MartinavdM/TP_AAA/README.md

# TP_AAA

# Scéance 1: Commande des transistors
