MartinavdM/TP_AAA/Inverter_Kicad_Project/Arm_IRF540NBbF.kicad_sch

## KiCad design Inverter_Kicad_Project/Arm_IRF540NBbF.kicad_sch (2023-10-02, last stored version)

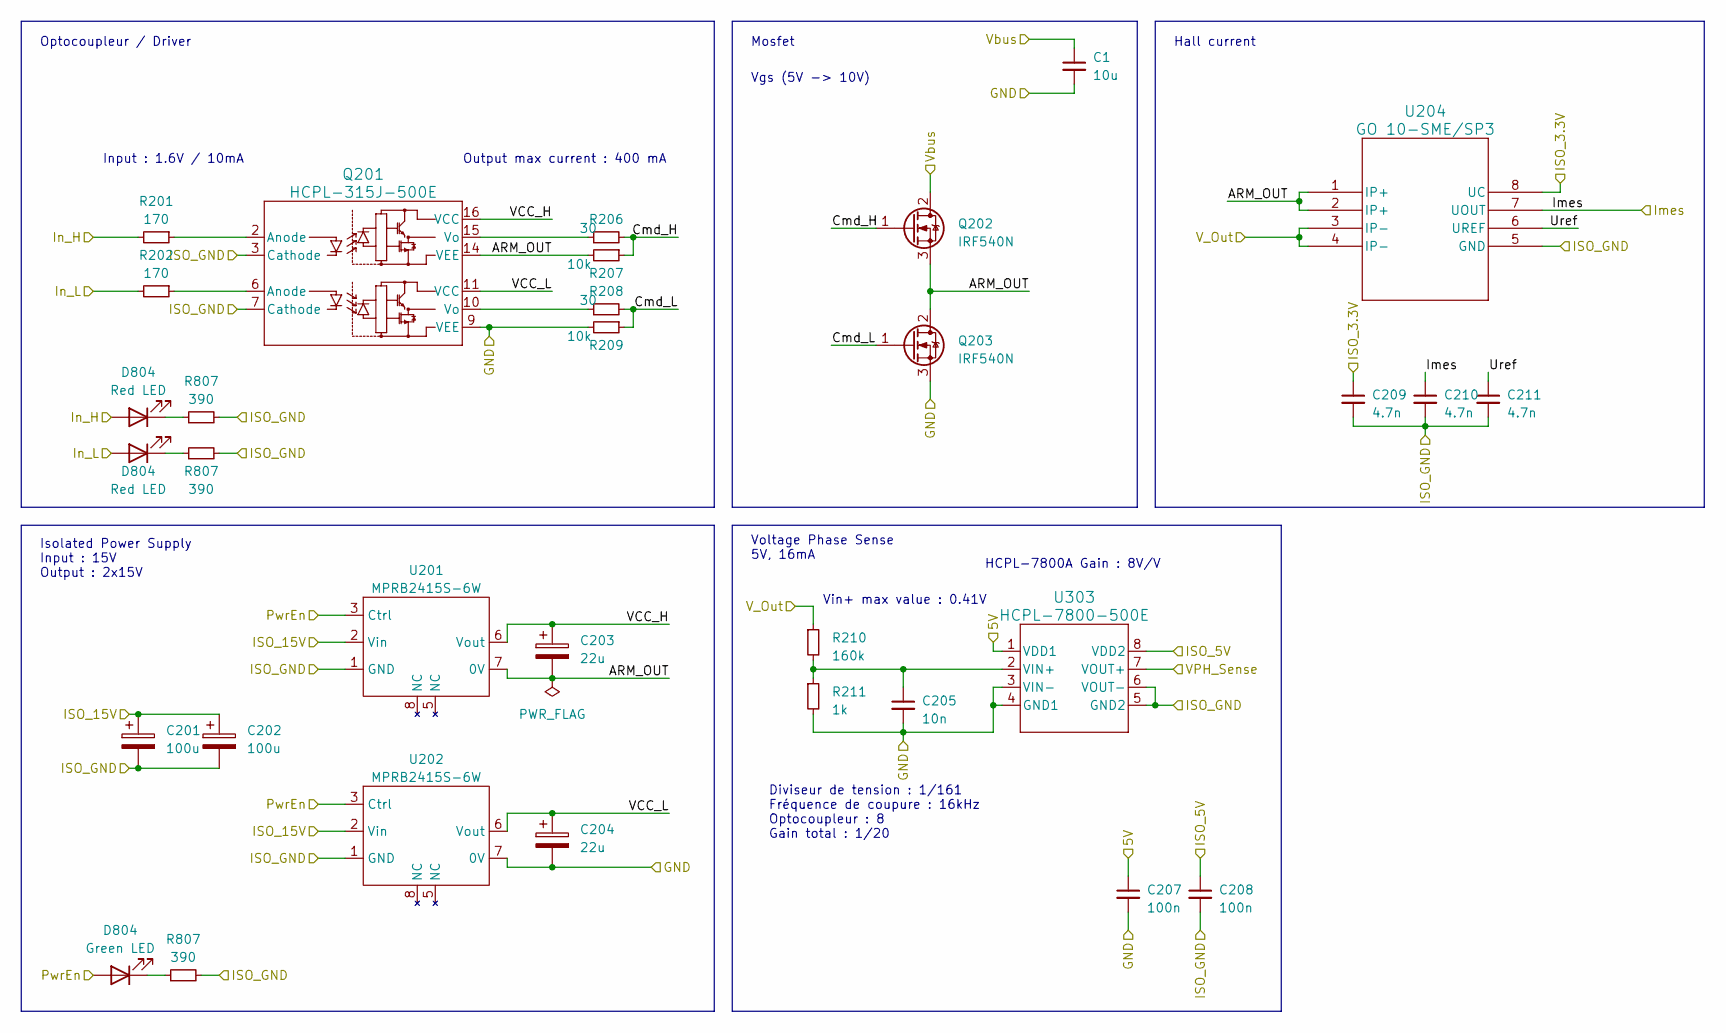
[picture p1: schematic Arm_IRF540NBbF.kicad_sch]

Parts:
C1: 10u; C_2220_5650Metric
C201, C202: 100u; CP_Elec_6.3x7.7
C203, C204: 22u; CP_Elec_5x5.4
C205: 10n; C_0402_1005Metric
C207, C208: 100n; C_0402_1005Metric
C209, C210, C211: 4.7n; C_0402_1005Metric
D804: Red LED; LED_0603_1608Metric
Q201: HCPL-315J-500E; SO-16_HCPL-315J_BRA
Q202, Q203: IRF540N; TO-220-3_Vertical
R201, R202: 170; R_0402_1005Metric
R206, R208: 30; R_1206_3216Metric
R207, R209: 10k; R_0402_1005Metric
R210: 160k; R_0402_1005Metric
R211: 1k; R_0402_1005Metric
R807: 390; R_0402_1005Metric
U201, U202: MPRB2415S-6W; MPRB2415S
U204: GO 10-SME/SP3; SOIC8-GO-SME&slash_SP3_LEM
U303: HCPL-7800-500E; DIP-8 Gull Wing

Connections:
5V: C207.1, U303.1 (VDD1)
ARM_OUT: C203.2, Q201.14 (VEE), Q202.3 (S), Q203.2 (D), R207.2, U201.7 (0V), U204.1 (IP+), U204.2 (IP+)
Cmd_H: Q202.1 (G), R206.2, R207.1
Cmd_L: Q203.1 (G), R208.2, R209.1
GND: C1.2, C204.2, C205.2, C207.2, Q201.9 (VEE), Q203.3 (S), R209.2, R211.2, U202.7 (0V), U303.3 (VIN-), U303.4 (GND1)
ISO_3.3V: C209.1, U204.8 (UC)
ISO_5V: C208.1, U303.8 (VDD2)
ISO_15V: C201.1, C202.1, U201.2 (Vin), U202.2 (Vin)
ISO_GND: C201.2, C202.2, C208.2, C209.2, C210.2, C211.2, Q201.3 (Cathode), Q201.7 (Cathode), R807.2, U201.1 (GND), U202.1 (GND), U204.5 (GND), U303.5 (GND2), U303.6 (VOUT-)
Imes: C210.1, U204.7 (UOUT)
In_H: D804.2 (A), R201.2
In_L: D804.2 (A), R202.2
unnamed: C205.1, R210.2, R211.1, U303.2 (VIN+)
unnamed: D804.1 (K), R807.1
unnamed: Q201.2 (Anode), R201.1
unnamed: Q201.6 (Anode), R202.1
unnamed: Q201.10 (Vo), R208.1
unnamed: Q201.15 (Vo), R206.1
PwrEn: D804.2 (A), U201.3 (Ctrl), U202.3 (Ctrl)
Uref: C211.1, U204.6 (UREF)
VCC_H: C203.1, Q201.16 (VCC), U201.6 (Vout)
VCC_L: C204.1, Q201.11 (VCC), U202.6 (Vout)
VPH_Sense: U303.7 (VOUT+)
V_Out: R210.1, U204.3 (IP-), U204.4 (IP-)
Vbus: C1.1, Q202.2 (D)

Notes on the sheet:
Hall current
Isolated Power Supply Input : 15V Output : 2x15V
Output max current : 400 mA
Input : 1.6V / 10mA
Voltage Phase Sense 5V, 16mA
Vgs (5V -> 10V)
Vin+ max value : 0.41V
Mosfet
Optocoupleur / Driver
Diviseur de tension : 1/161 Fréquence de coupure : 16kHz Optocoupleur : 8 Gain total : 1/20
HCPL-7800A Gain : 8V/V
