MartinavdM/TP_AAA/Inverter_Kicad_Project/FAN.kicad_sch

## KiCad design Inverter_Kicad_Project/FAN.kicad_sch (2023-10-02, last stored version)

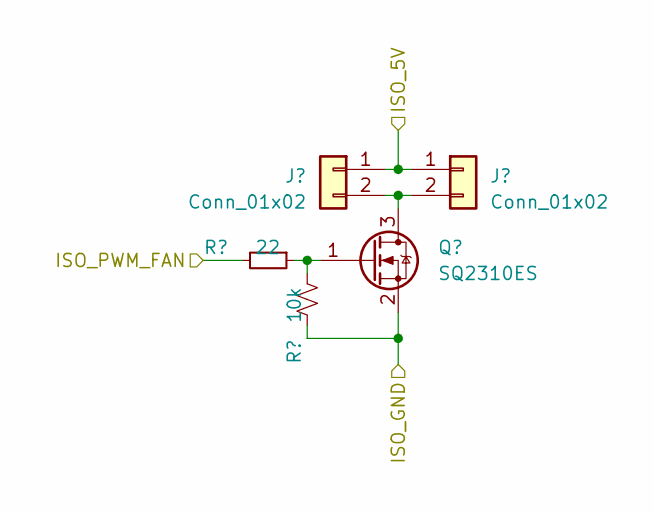
[picture p2: schematic FAN.kicad_sch]

Parts:
J1101, J1102: Conn_01x02; JST_XH_B2B-XH-A_1x02_P2.50mm_Vertical
Q1101: SQ2310ES; SOT-23
R1101: 22; R_0402_1005Metric
R1102: 10k; R_0402_1005Metric

Connections:
ISO_5V: J1101.1, J1102.1
ISO_GND: Q1101.2 (S), R1102.2
ISO_PWM_FAN: R1101.2
unnamed: J1101.2, J1102.2, Q1101.3 (D)
unnamed: Q1101.1 (G), R1101.1, R1102.1
