MartinavdM/TP_AAA/Inverter_Kicad_Project/Inverter_KiCAD.kicad_sch

## KiCad design Inverter_Kicad_Project/Inverter_KiCAD.kicad_sch (2023-10-02, last stored version)

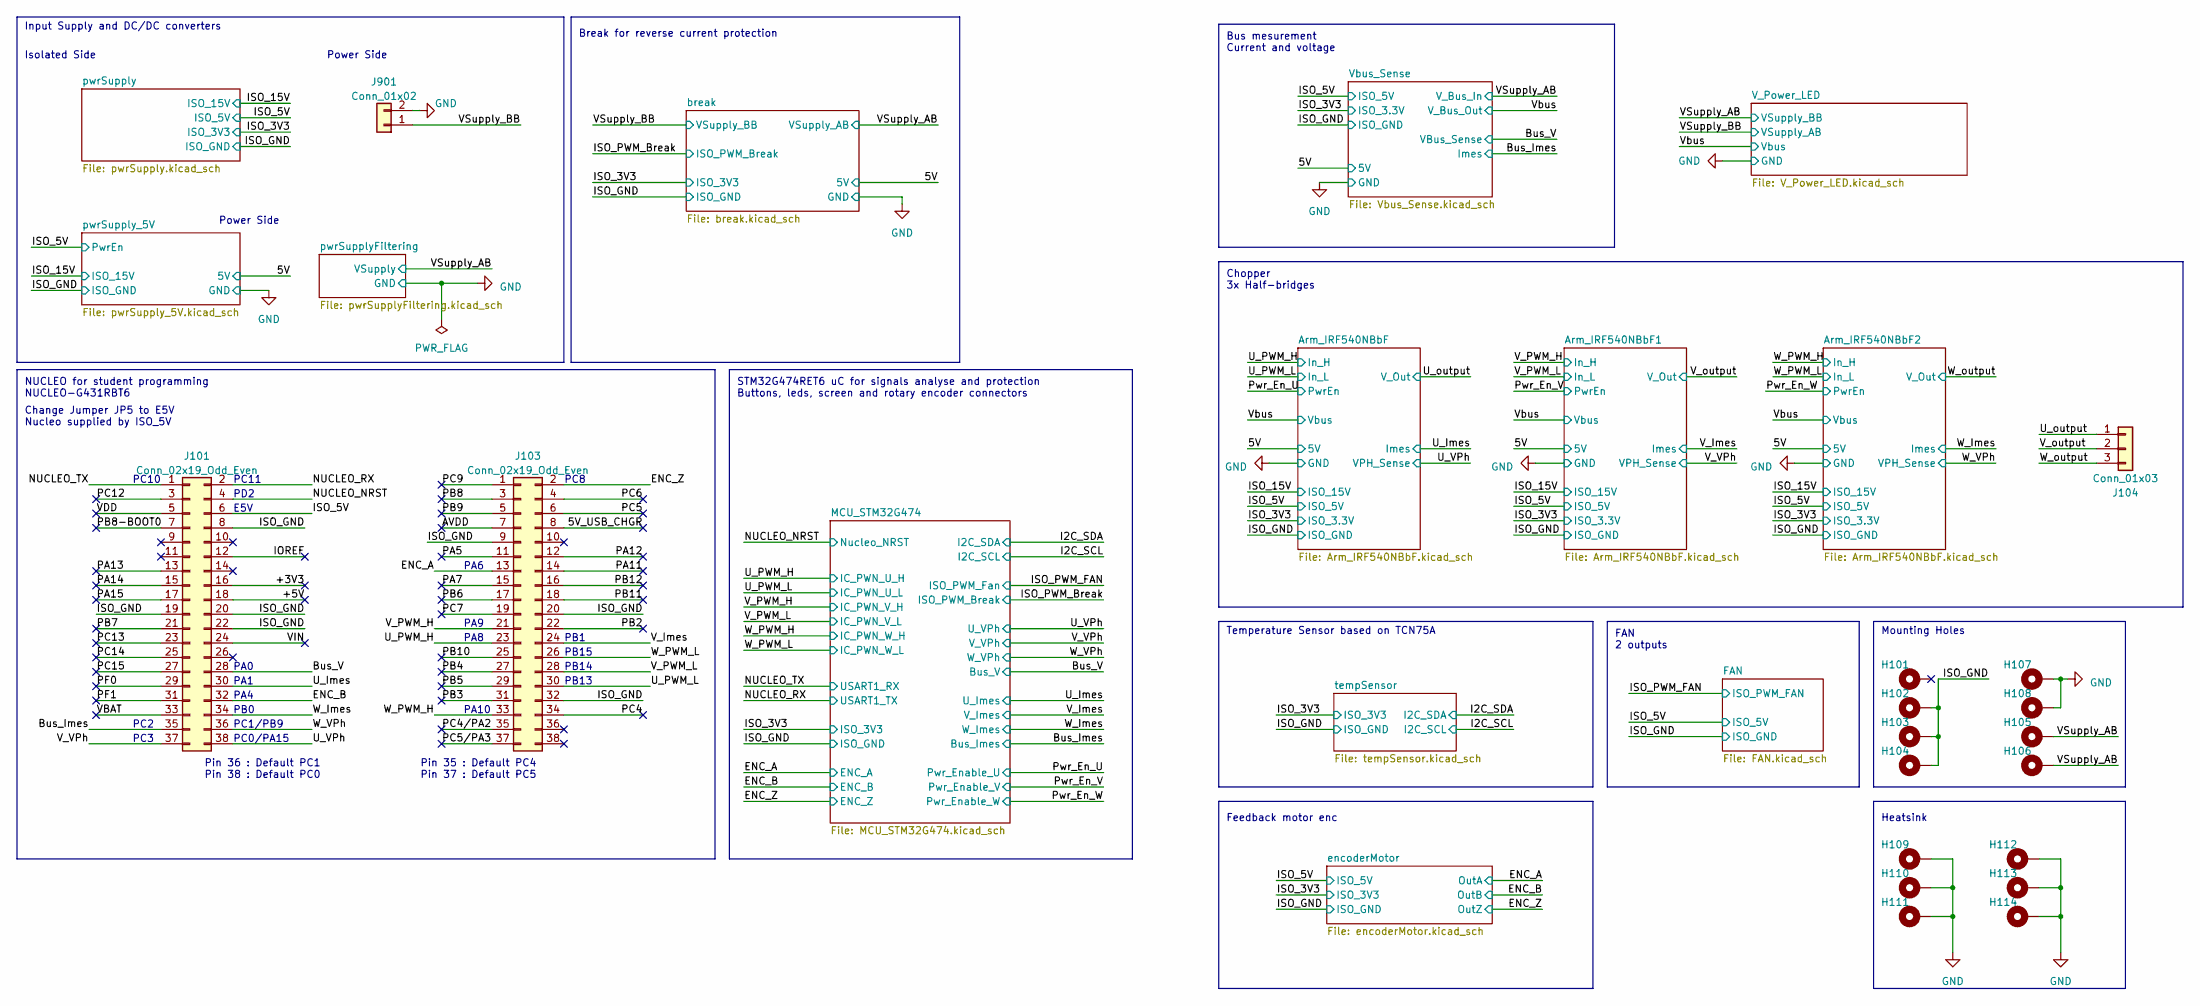
[picture p3: schematic Inverter_KiCAD.kicad_sch]

Parts:
H101, H102, H103, H104, H105, H106, H107, H108, H109, H110, H111, H112, H113, H114: MountingHole_Pad; MountingHole_3.2mm_M3_Pad_Via
J101, J103: Conn_02x19_Odd_Even; PinHeader_2x19_P2.54mm_Vertical
J104: Conn_01x03; 691311500103
J901: Conn_01x02; 691311500102

Connections:
5V_USB_CHGR: J103.8
+3V3: J101.16
+5V: J101.18
AVDD: J103.7
Bus_Imes: J101.35
Bus_V: J101.28
ENC_A: J103.13
ENC_B: J101.32
ENC_Z: J103.2
GND: H107.1, H108.1, H109.1, H110.1, H111.1, H112.1, H113.1, H114.1, J901.2
IOREF: J101.12
ISO_5V: J101.6
ISO_GND: H102.1, H103.1, H104.1, J101.8, J101.19, J101.20, J101.22, J103.9, J103.20, J103.32
NUCLEO_NRST: J101.4
NUCLEO_RX: J101.2
NUCLEO_TX: J101.1
PA5: J103.11
PA7: J103.15
PA11: J103.14
PA12: J103.12
PA13: J101.13
PA14: J101.15
PA15: J101.17
PB2: J103.22
PB3: J103.31
PB4: J103.27
PB5: J103.29
PB6: J103.17
PB7: J101.21
PB8: J103.3
PB8-BOOT0: J101.7
PB9: J103.5
PB10: J103.25
PB11: J103.18
PB12: J103.16
PC4: J103.34
PC4/PA2: J103.35
PC5: J103.6
PC5/PA3: J103.37
PC6: J103.4
PC7: J103.19
PC9: J103.1
PC12: J101.3
PC13: J101.23
PC14: J101.25
PC15: J101.27
PF0: J101.29
PF1: J101.31
U_Imes: J101.30
U_PWM_H: J103.23
U_PWM_L: J103.30
U_VPh: J101.38
U_output: J104.1
VBAT: J101.33
VDD: J101.5
VIN: J101.24
VSupply_AB: H105.1, H106.1
VSupply_BB: J901.1
V_Imes: J103.24
V_PWM_H: J103.21
V_PWM_L: J103.28
V_VPh: J101.37
V_output: J104.2
W_Imes: J101.34
W_PWM_H: J103.33
W_PWM_L: J103.26
W_VPh: J101.36
W_output: J104.3

Notes on the sheet:
PB14
PC10
Input Supply and DC/DC converters
Temperature Sensor based on TCN75A
PC3
PA8
Mounting Holes
PA4
NUCLEO for student programming NUCLEO-G431RBT6
Pin 35 : Default PC4 Pin 37 : Default PC5
PA10
STM32G474RET6 uC for signals analyse and protection Buttons, leds, screen and rotary encoder connectors
Heatsink
Break for reverse current protection
PB13
Chopper 3x Half-bridges
PA0
PC0/PA15
PD2
E5V
PB0
PA9
Power Side
Feedback motor enc
Isolated Side
PA6
PC11
FAN 2 outputs
PA1
Pin 36 : Default PC1 Pin 38 : Default PC0
PC1/PB9
PC8
PB1
PC2
Bus mesurement Current and voltage
PB15
Change Jumper JP5 to E5V Nucleo supplied by ISO_5V
