MartinavdM/TP_AAA/Inverter_Kicad_Project/MCU_STM32G474.kicad_sch

## KiCad design Inverter_Kicad_Project/MCU_STM32G474.kicad_sch (2023-10-02, last stored version)

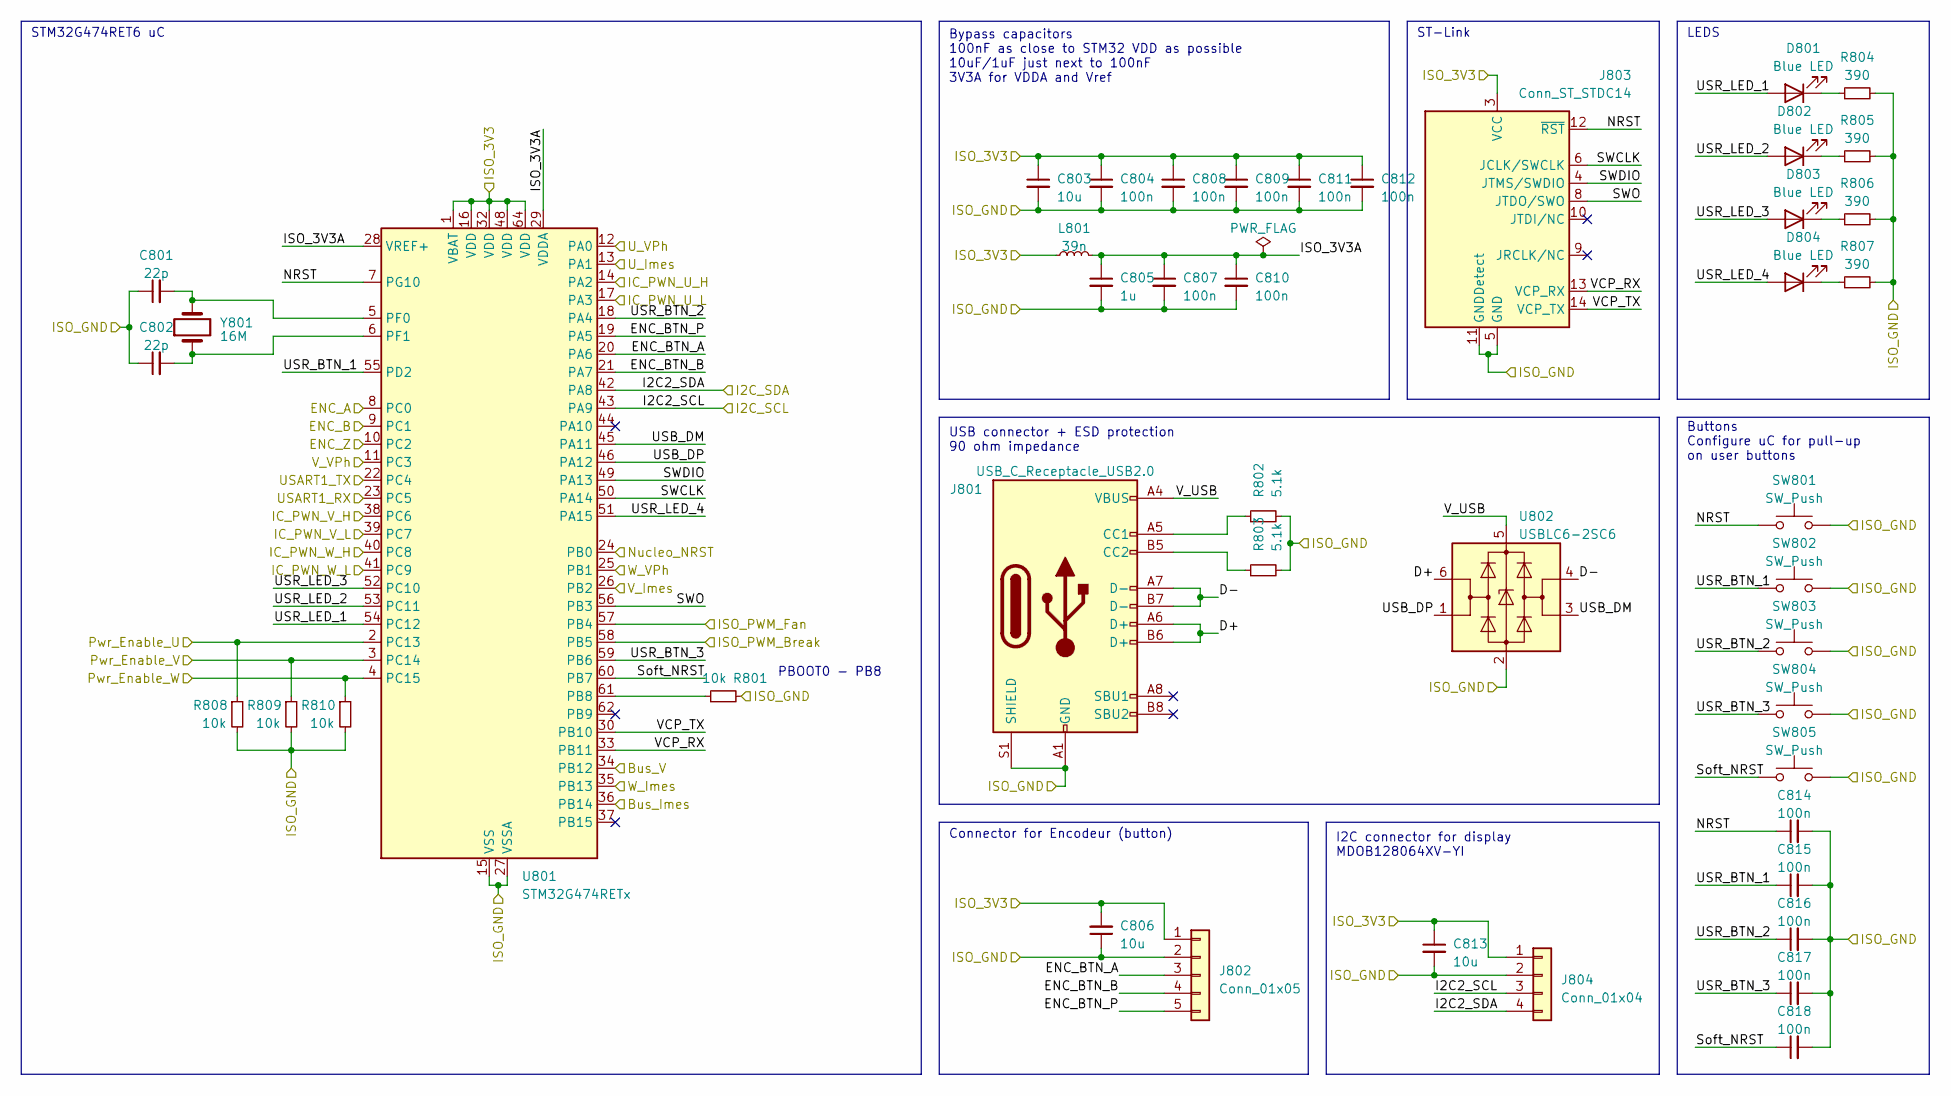
[picture p4: schematic MCU_STM32G474.kicad_sch]

Parts:
C801, C802: 22p; C_0402_1005Metric
C803, C806, C813: 10u; C_0603_1608Metric
C804, C807, C808, C809, C810, C811, C812, C814, C815, C816, C817, C818: 100n; C_0402_1005Metric
C805: 1u; C_0402_1005Metric
D801, D802, D803, D804: Blue LED; LED_0603_1608Metric
J801: USB_C_Receptacle_USB2.0; USB_C_Receptacle_HRO_TYPE-C-31-M-12
J802: Conn_01x05; JST_XH_B5B-XH-A_1x05_P2.50mm_Vertical
J803: Conn_ST_STDC14; PinHeader_2x07_P1.27mm_Vertical_SMD
J804: Conn_01x04; JST_XH_B4B-XH-A_1x04_P2.50mm_Vertical
L801: 39n; L_0603_1608Metric
R801, R808, R809, R810: 10k; R_0402_1005Metric
R802, R803: 5.1k; R_0402_1005Metric
R804, R805, R806, R807: 390; R_0402_1005Metric
SW801, SW802, SW803, SW804, SW805: SW_Push; 435451019820
U801: STM32G474RETx; LQFP-64_10x10mm_P0.5mm
U802: USBLC6-2SC6; SOT-23-6
Y801: 16M; ABLS-7.3728MHZ-CL-RESR-A-1-G-F

Connections:
Bus_Imes: U801.36 (PB14)
Bus_V: U801.34 (PB12)
D+: J801.A6 (D+), J801.B6 (D+), U802.6 (I/O1)
D-: J801.A7 (D-), J801.B7 (D-), U802.4 (I/O2)
ENC_A: U801.8 (PC0)
ENC_B: U801.9 (PC1)
ENC_BTN_A: J802.3, U801.20 (PA6)
ENC_BTN_B: J802.4, U801.21 (PA7)
ENC_BTN_P: J802.5, U801.19 (PA5)
ENC_Z: U801.10 (PC2)
I2C2_SCL: J804.3, U801.43 (PA9)
I2C2_SDA: J804.4, U801.42 (PA8)
IC_PWN_U_H: U801.14 (PA2)
IC_PWN_U_L: U801.17 (PA3)
IC_PWN_V_H: U801.38 (PC6)
IC_PWN_V_L: U801.39 (PC7)
IC_PWN_W_H: U801.40 (PC8)
IC_PWN_W_L: U801.41 (PC9)
ISO_3V3: C803.1, C804.1, C806.2, C808.1, C809.1, C811.1, C812.1, C813.1, J802.1, J803.3 (VCC), J804.1, L801.1, U801.1 (VBAT), U801.16 (VDD), U801.32 (VDD), U801.48 (VDD), U801.64 (VDD)
ISO_3V3A: C805.1, C807.1, C810.1, L801.2, U801.28 (VREF+), U801.29 (VDDA)
ISO_GND: C801.1, C802.1, C803.2, C804.2, C805.2, C806.1, C807.2, C808.2, C809.2, C810.2, C811.2, C812.2, C813.2, C814.2, C815.2, C816.2, C817.2, C818.2, J801.A1 (GND), J801.A12 (GND), J801.B1 (GND), J801.B12 (GND), J801.S1 (SHIELD), J802.2, J803.5 (GND), J803.7 (GND), J803.11 (GNDDetect), J804.2, R801.2, R802.2, R803.2, R804.2, R805.2, R806.2, R807.2, R808.2, R809.2, R810.2, SW801.2, SW802.2, SW803.2, SW804.2, SW805.2, U801.15 (VSS), U801.27 (VSSA), U801.31 (VSS), U801.47 (VSS), U801.63 (VSS), U802.2 (GND)
ISO_PWM_Break: U801.58 (PB5)
ISO_PWM_Fan: U801.57 (PB4)
NRST: C814.1, J803.12 (~RST), SW801.1, U801.7 (PG10)
unnamed: C801.2, U801.5 (PF0), Y801.2
unnamed: C802.2, U801.6 (PF1), Y801.1
unnamed: D801.1 (K), R804.1
unnamed: D802.1 (K), R805.1
unnamed: D803.1 (K), R806.1
unnamed: D804.1 (K), R807.1
unnamed: J801.A5 (CC1), R802.1
unnamed: J801.B5 (CC2), R803.1
unnamed: R801.1, U801.61 (PB8)
Nucleo_NRST: U801.24 (PB0)
Pwr_Enable_U: R808.1, U801.2 (PC13)
Pwr_Enable_V: R809.1, U801.3 (PC14)
Pwr_Enable_W: R810.1, U801.4 (PC15)
SWCLK: J803.6 (JCLK/SWCLK), U801.50 (PA14)
SWDIO: J803.4 (JTMS/SWDIO), U801.49 (PA13)
SWO: J803.8 (JTDO/SWO), U801.56 (PB3)
Soft_NRST: C818.1, SW805.1, U801.60 (PB7)
USART1_RX: U801.23 (PC5)
USART1_TX: U801.22 (PC4)
USB_DM: U801.45 (PA11), U802.3 (I/O2)
USB_DP: U801.46 (PA12), U802.1 (I/O1)
USR_BTN_1: C815.1, SW802.1, U801.55 (PD2)
USR_BTN_2: C816.1, SW803.1, U801.18 (PA4)
USR_BTN_3: C817.1, SW804.1, U801.59 (PB6)
USR_LED_1: D801.2 (A), U801.54 (PC12)
USR_LED_2: D802.2 (A), U801.53 (PC11)
USR_LED_3: D803.2 (A), U801.52 (PC10)
USR_LED_4: D804.2 (A), U801.51 (PA15)
U_Imes: U801.13 (PA1)
U_VPh: U801.12 (PA0)
VCP_RX: J803.13 (VCP_RX), U801.33 (PB11)
VCP_TX: J803.14 (VCP_TX), U801.30 (PB10)
V_Imes: U801.26 (PB2)
V_USB: J801.A4 (VBUS), J801.A9 (VBUS), J801.B4 (VBUS), J801.B9 (VBUS), U802.5 (VBUS)
V_VPh: U801.11 (PC3)
W_Imes: U801.35 (PB13)
W_VPh: U801.25 (PB1)

Notes on the sheet:
USB connector + ESD protection 90 ohm impedance
ST-Link
Bypass capacitors 100nF as close to STM32 VDD as possible 10uF/1uF just next to 100nF 3V3A for VDDA and Vref
Connector for Encodeur (button)
Buttons Configure uC for pull-up on user buttons
I2C connector for display MDOB128064XV-YI
PBOOT0 - PB8
STM32G474RET6 uC
LEDS
