MartinavdM/TP_AAA/Inverter_Kicad_Project/V_Power_LED.kicad_sch

## KiCad design Inverter_Kicad_Project/V_Power_LED.kicad_sch (2023-10-02, last stored version)

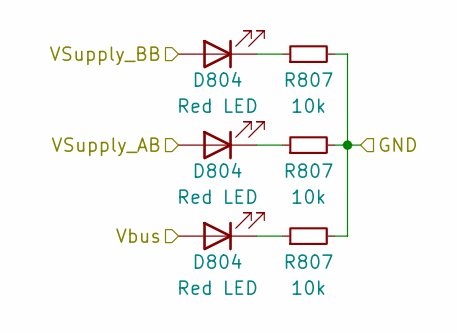
[picture p5: schematic V_Power_LED.kicad_sch]

Parts:
D804: Red LED; LED_0603_1608Metric
R807: 10k; R_0402_1005Metric

Connections:
GND: R807.2
unnamed: D804.1 (K), R807.1
VSupply_AB: D804.2 (A)
VSupply_BB: D804.2 (A)
Vbus: D804.2 (A)
