MartinavdM/TP_AAA/Inverter_Kicad_Project/Vbus_Sense.kicad_sch

## KiCad design Inverter_Kicad_Project/Vbus_Sense.kicad_sch (2023-10-02, last stored version)

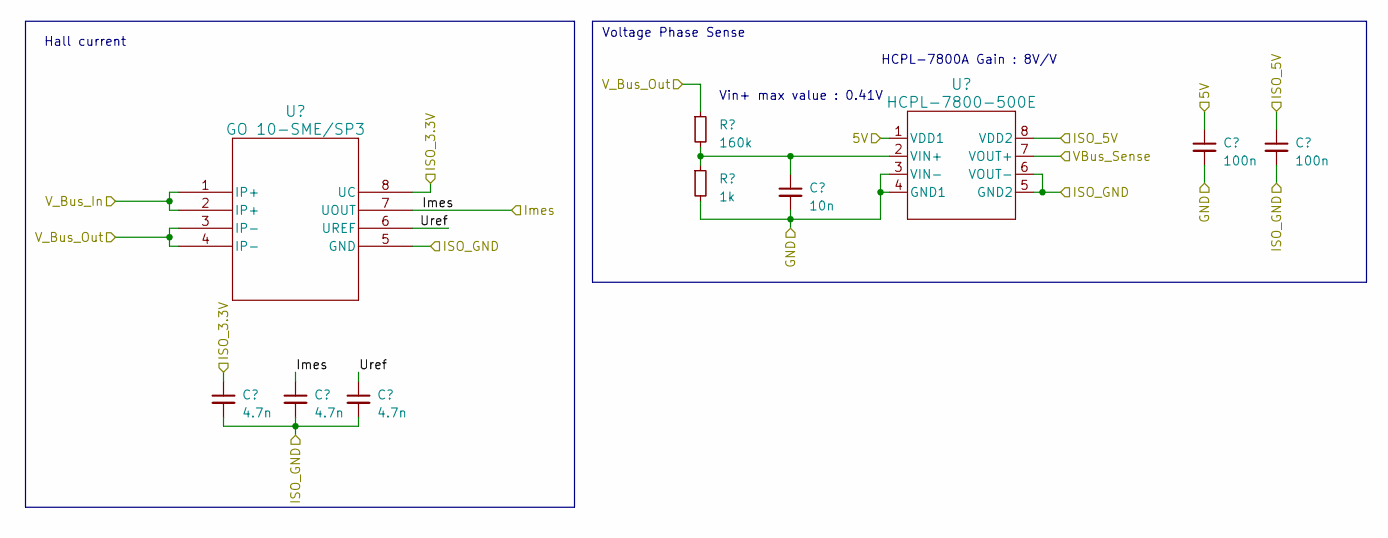
[picture p6: schematic Vbus_Sense.kicad_sch]

Parts:
C601, C602, C603: 4.7n; C_0402_1005Metric
C604: 10n; C_0402_1005Metric
C605, C606: 100n; C_0402_1005Metric
R601: 160k; R_0402_1005Metric
R602: 1k; R_0402_1005Metric
U601: GO 10-SME/SP3; SOIC8-GO-SME&slash_SP3_LEM
U602: HCPL-7800-500E; DIP-8 Gull Wing

Connections:
5V: C605.1, U602.1 (VDD1)
GND: C604.2, C605.2, R602.2, U602.3 (VIN-), U602.4 (GND1)
ISO_3.3V: C601.1, U601.8 (UC)
ISO_5V: C606.1, U602.8 (VDD2)
ISO_GND: C601.2, C602.2, C603.2, C606.2, U601.5 (GND), U602.5 (GND2), U602.6 (VOUT-)
Imes: C602.1, U601.7 (UOUT)
unnamed: C604.1, R601.2, R602.1, U602.2 (VIN+)
Uref: C603.1, U601.6 (UREF)
VBus_Sense: U602.7 (VOUT+)
V_Bus_In: U601.1 (IP+), U601.2 (IP+)
V_Bus_Out: R601.1, U601.3 (IP-), U601.4 (IP-)

Notes on the sheet:
Hall current
Vin+ max value : 0.41V
HCPL-7800A Gain : 8V/V
Voltage Phase Sense
