MartinavdM/TP_AAA/Inverter_Kicad_Project/break.kicad_sch

## KiCad design Inverter_Kicad_Project/break.kicad_sch (2023-10-02, last stored version)

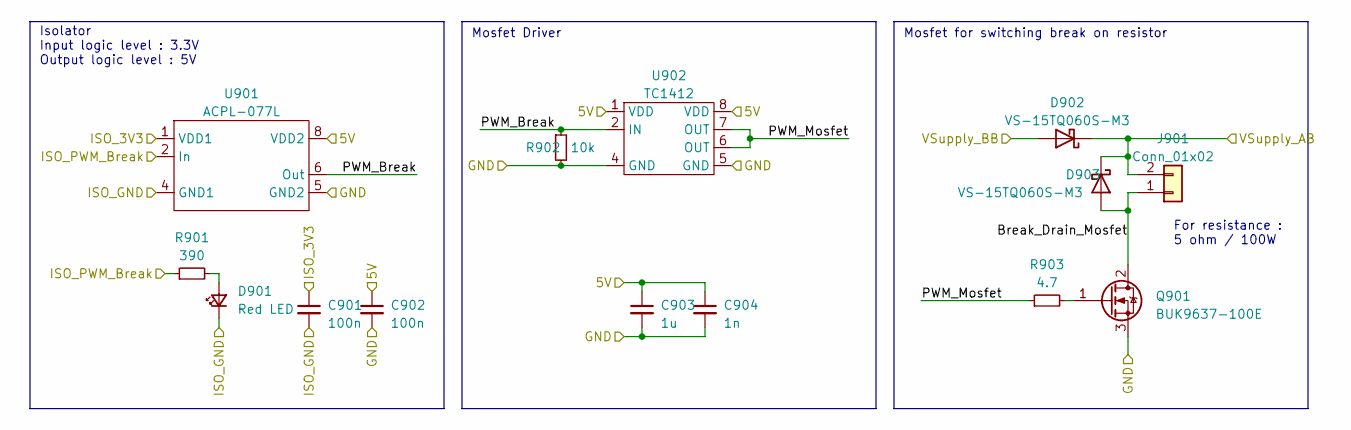
[picture p7: schematic break.kicad_sch]

Parts:
C901, C902: 100n; C_0402_1005Metric
C903: 1u; C_0402_1005Metric
C904: 1n; C_0402_1005Metric
D901: Red LED; LED_0603_1608Metric
D902, D903: VS-15TQ060S-M3; TO-263-2
J901: Conn_01x02; 691311500102
Q901: BUK9637-100E; TO-263-2
R901: 390; R_0402_1005Metric
R902: 10k; R_0402_1005Metric
R903: 4.7; R_1206_3216Metric
U901: ACPL-077L; SO-8_3.9x4.9mm_P1.27mm
U902: TC1412; SOIC-8_3.9x4.9mm_P1.27mm

Connections:
5V: C902.1, C903.1, C904.1, U901.8 (VDD2), U902.1 (VDD), U902.8 (VDD)
Break_Drain_Mosfet: D903.3 (A), J901.1, Q901.2 (D)
GND: C902.2, C903.2, C904.2, Q901.3 (S), R902.2, U901.5 (GND2), U902.4 (GND), U902.5 (GND)
ISO_3V3: C901.1, U901.1 (VDD1)
ISO_GND: C901.2, D901.1 (K), U901.4 (GND1)
ISO_PWM_Break: R901.1, U901.2 (In)
unnamed: D901.2 (A), R901.2
unnamed: Q901.1 (G), R903.2
PWM_Break: R902.1, U901.6 (Out), U902.2 (IN)
PWM_Mosfet: R903.1, U902.6 (OUT), U902.7 (OUT)
VSupply_AB: D902.2 (K), D903.2 (K), J901.2
VSupply_BB: D902.3 (A)

Notes on the sheet:
Isolator Input logic level : 3.3V Output logic level : 5V
For resistance : 5 ohm / 100W
Mosfet for switching break on resistor
Mosfet Driver
