MartinavdM/TP_AAA/Inverter_Kicad_Project/encoderMotor.kicad_sch

## KiCad design Inverter_Kicad_Project/encoderMotor.kicad_sch (2023-10-02, last stored version)

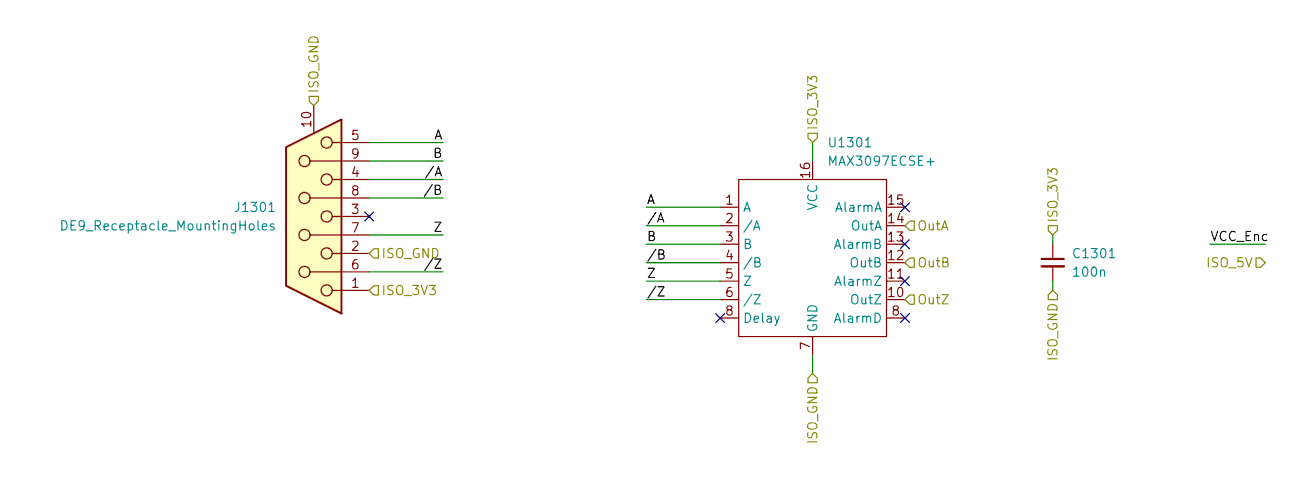
[picture p8: schematic encoderMotor.kicad_sch]

Parts:
C1301: 100n; C_0402_1005Metric
J1301: DE9_Receptacle_MountingHoles; 618009233821
U1301: MAX3097ECSE+; SOIC-16_3.9x9.9mm_P1.27mm

Connections:
A: J1301.5, U1301.1 (A)
B: J1301.9, U1301.3 (B)
ISO_3V3: C1301.1, J1301.1, U1301.16 (VCC)
ISO_GND: C1301.2, J1301.2, J1301.10 (PAD), U1301.7 (GND)
OutA: U1301.14 (OutA)
OutB: U1301.12 (OutB)
OutZ: U1301.10 (OutZ)
Z: J1301.7, U1301.5 (Z)
/A: J1301.4, U1301.2 (/A)
/B: J1301.8, U1301.4 (/B)
/Z: J1301.6, U1301.6 (/Z)
