MartinavdM/TP_AAA/Inverter_Kicad_Project/pwrSupply.kicad_sch

## KiCad design Inverter_Kicad_Project/pwrSupply.kicad_sch (2023-10-02, last stored version)

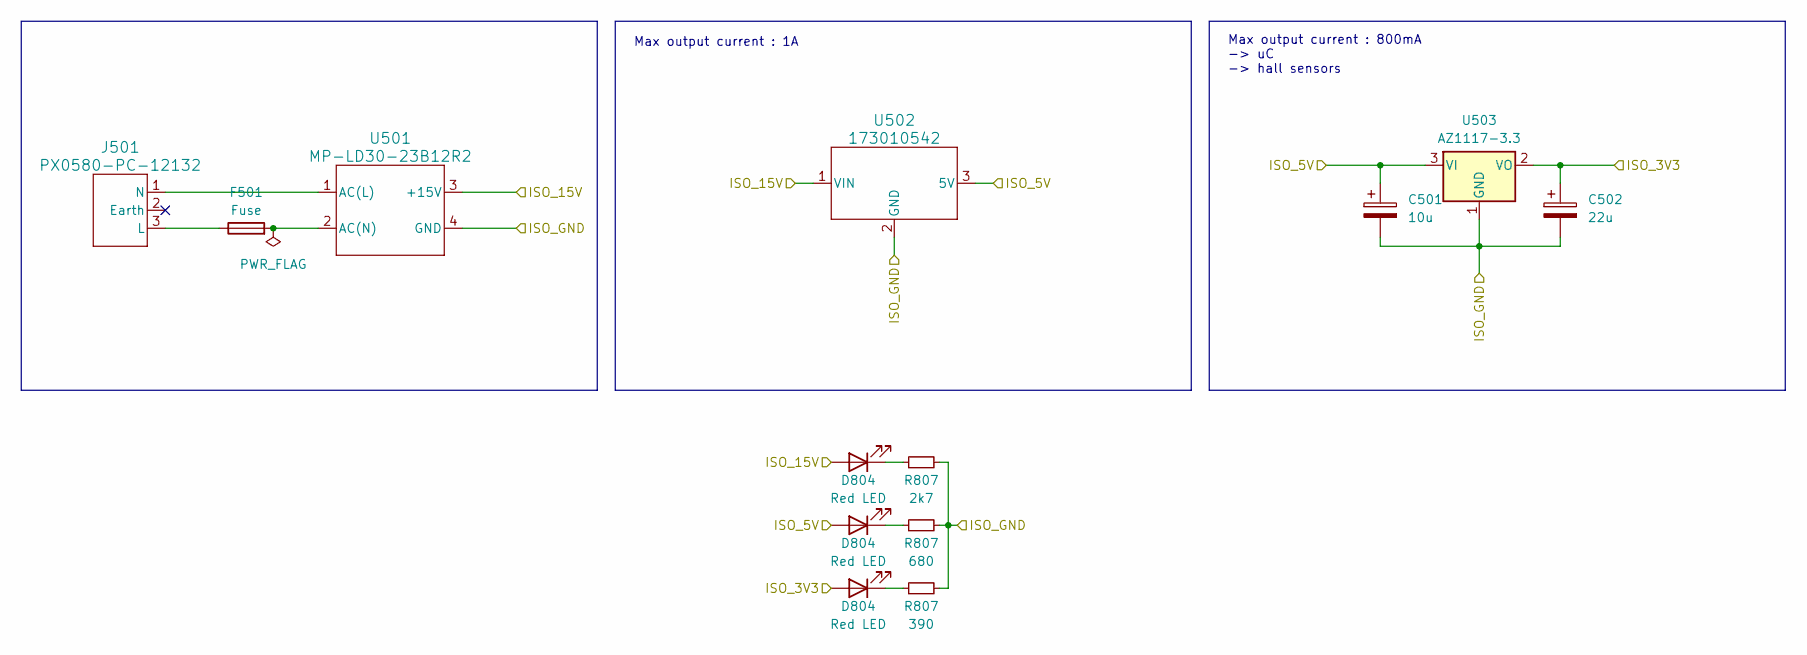
[picture p9: schematic pwrSupply.kicad_sch]

Parts:
C501: 10u; CP_Elec_4x5.4
C502: 22u; CP_Elec_5x5.4
D804: Red LED; LED_0603_1608Metric
F501: Fuse; 0031.8201
J501: PX0580-PC-12132
R807: 2k7; R_0402_1005Metric
U501: MP-LD30-23B12R2; MP-LD30-23B15R2
U502: 173010542; 173010578
U503: AZ1117-3.3; SOT-223-3_TabPin2

Connections:
ISO_3V3: C502.1, D804.2 (A), U503.2 (VO)
ISO_5V: C501.1, D804.2 (A), U502.3 (5V), U503.3 (VI)
ISO_15V: D804.2 (A), U501.3 (+15V), U502.1 (VIN)
ISO_GND: C501.2, C502.2, R807.2, U501.4 (GND), U502.2 (GND), U503.1 (GND)
unnamed: D804.1 (K), R807.1
unnamed: F501.1, J501.3 (L)
unnamed: F501.2, U501.2 (AC(N))
unnamed: J501.1 (N), U501.1 (AC(L))

Notes on the sheet:
Max output current : 800mA -> uC -> hall sensors
Max output current : 1A
