MartinavdM/TP_AAA/Inverter_Kicad_Project/pwrSupplyFiltering.kicad_sch

## KiCad design Inverter_Kicad_Project/pwrSupplyFiltering.kicad_sch (2023-10-02, last stored version)

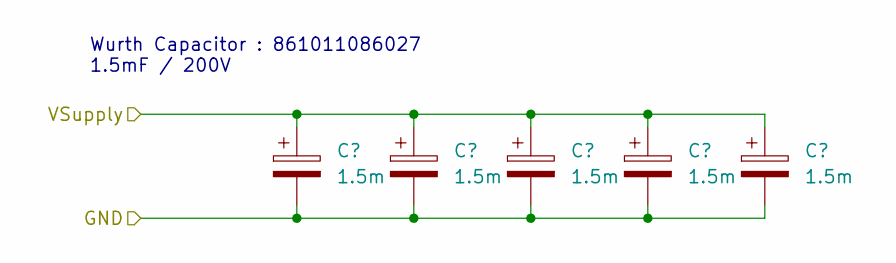
[picture p10: schematic pwrSupplyFiltering.kicad_sch]

Parts:
C1001, C1002, C1003, C1004, C1005: 1.5m; CP_Radial_D35.0mm_P10.00mm_SnapIn

Connections:
GND: C1001.2, C1002.2, C1003.2, C1004.2, C1005.2
VSupply: C1001.1, C1002.1, C1003.1, C1004.1, C1005.1

Notes on the sheet:
Wurth Capacitor : 861011086027 1.5mF / 200V
