MartinavdM/TP_AAA/Inverter_Kicad_Project/pwrSupply_5V.kicad_sch

## KiCad design Inverter_Kicad_Project/pwrSupply_5V.kicad_sch (2023-10-02, last stored version)

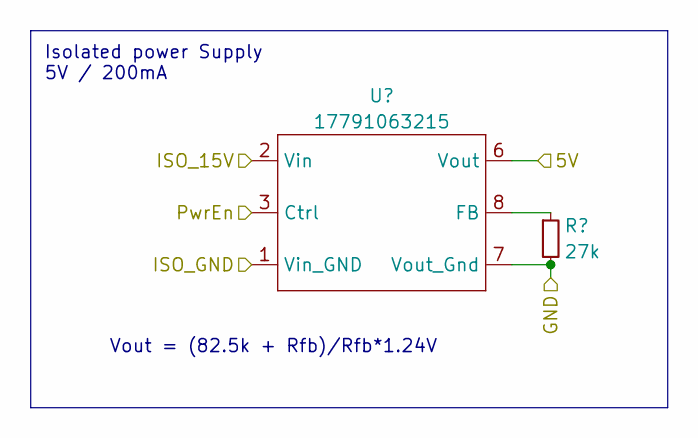
[picture p11: schematic pwrSupply_5V.kicad_sch]

Parts:
R701: 27k; R_0402_1005Metric
U701: 17791063215

Connections:
5V: U701.6 (Vout)
GND: R701.2, U701.7 (Vout_Gnd)
ISO_15V: U701.2 (Vin)
ISO_GND: U701.1 (Vin_GND)
unnamed: R701.1, U701.8 (FB)
PwrEn: U701.3 (Ctrl)

Notes on the sheet:
Vout = (82.5k + Rfb)/Rfb*1.24V
Isolated power Supply 5V / 200mA
