MartinavdM/TP_AAA/Inverter_Kicad_Project/pwrSupply_5V_Isolated.kicad_sch

## KiCad design Inverter_Kicad_Project/pwrSupply_5V_Isolated.kicad_sch (2023-10-02, last stored version)

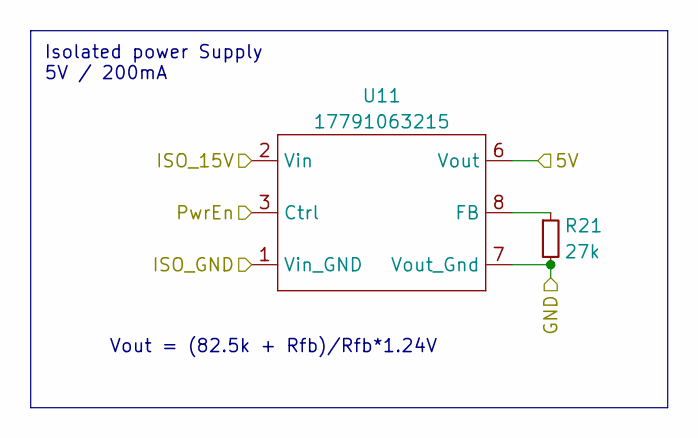
[picture p12: schematic pwrSupply_5V_Isolated.kicad_sch]

Parts:
R21: 27k
U11: 17791063215

Connections:
5V: U11.6 (Vout)
GND: R21.2, U11.7 (Vout_Gnd)
ISO_15V: U11.2 (Vin)
ISO_GND: U11.1 (Vin_GND)
unnamed: R21.1, U11.8 (FB)
PwrEn: U11.3 (Ctrl)

Notes on the sheet:
Vout = (82.5k + Rfb)/Rfb*1.24V
Isolated power Supply 5V / 200mA
