MartinavdM/TP_AAA/Inverter_Kicad_Project/tempSensor.kicad_sch

## KiCad design Inverter_Kicad_Project/tempSensor.kicad_sch (2023-10-02, last stored version)

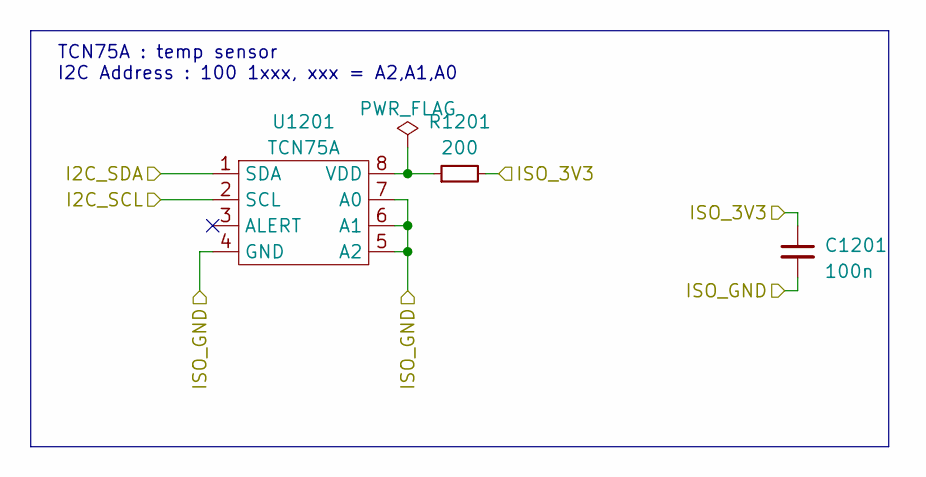
[picture p13: schematic tempSensor.kicad_sch]

Parts:
C1201: 100n; C_0402_1005Metric
R1201: 200; R_0402_1005Metric
U1201: TCN75A; SOIC-8_3.9x4.9mm_P1.27mm

Connections:
I2C_SCL: U1201.2 (SCL)
I2C_SDA: U1201.1 (SDA)
ISO_3V3: C1201.1, R1201.2
ISO_GND: C1201.2, U1201.4 (GND), U1201.5 (A2), U1201.6 (A1), U1201.7 (A0)
unnamed: R1201.1, U1201.8 (VDD)

Notes on the sheet:
TCN75A : temp sensor I2C Address : 100 1xxx, xxx = A2,A1,A0
