MartinavdM/TP_AAA/Core/Src/main.c

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
/* Includes ------------------------------------------------------------------*/
#include "main.h"
#include "adc.h"
#include "dma.h"
#include "tim.h"
#include "usart.h"
#include "gpio.h"

/* USER CODE BEGIN Includes */
#include "mylibs/shell.h"
#include <math.h>
/* USER CODE END Includes */


/* USER CODE BEGIN PV */
uint32_t timeout = 100; //
float number_of_rotations = 0.0;
uint32_t counter = 0;
uint32_t count = 0;
float speed_table[100];
uint32_t ADC_buffer[ADC_BUF_SIZE];
uint8_t current_flag = 0; // flag used for the current computation callback
uint8_t speed_flag = 0; // flag used for the speed computation callback
/* USER CODE END PV */

void SystemClock_Config(void);
/**
  * @brief  The application entry point.
  * @retval int
  */
int main(void)
{
  /* USER CODE BEGIN 1 */
	for(int i=0;i<100;i++){
		speed_table[i] = 0.0; // speed_table is used for computing a mean speed
	}
  /* USER CODE END 1 */

  /* MCU Configuration--------------------------------------------------------*/

  /* Reset of all peripherals, Initializes the Flash interface and the Systick. */
  HAL_Init();

  /* Configure the system clock */
  SystemClock_Config();

  /* Initialize all configured peripherals */
  MX_GPIO_Init();
  MX_DMA_Init();
  MX_ADC2_Init();
  MX_ADC1_Init();
  MX_TIM1_Init();
  MX_TIM3_Init();
  MX_USART2_UART_Init();
  MX_USART3_UART_Init();
  MX_TIM7_Init();
  /* USER CODE BEGIN 2 */
	Shell_Init();
	if (HAL_ADCEx_Calibration_Start(&hadc1, ADC_SINGLE_ENDED) != HAL_OK)
		Error_Handler();
	if (HAL_ADC_Start_DMA(&hadc1, ADC_buffer, ADC_BUF_SIZE) != HAL_OK)
		Error_Handler();
//	if(HAL_TIM_Base_Start(&htim3) != HAL_OK)
//		Error_Handler();
	if (HAL_TIM_Encoder_Start_IT(&htim3, TIM_CHANNEL_ALL) != HAL_OK)
		Error_Handler();

  /* USER CODE END 2 */

  /* Infinite loop */
  /* USER CODE BEGIN WHILE */
	while (1) {
		Shell_Loop();

    /* USER CODE END WHILE */

    /* USER CODE BEGIN 3 */
	}
  /* USER CODE END 3 */
}

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
/* USER CODE BEGIN 4 */
void HAL_ADC_ConvCpltCallback(ADC_HandleTypeDef *hadc) {
	//			if(HAL_ADC_Stop_DMA(&hadc1) != HAL_OK)
	//				Error_Handler();
	current_flag = 1;
}

void HAL_TIM_IC_CaptureCallback(TIM_HandleTypeDef *htim) {
	if (htim->Instance == TIM3) {
		counter = __HAL_TIM_GET_COUNTER(htim);
//			count = (int16_t) counter;
		if (__HAL_TIM_IS_TIM_COUNTING_DOWN(htim)) {
			count = COUNTER_ARR - counter;
		} else {
			count = counter;
		}
		number_of_rotations = (count + 0.0) / 4096;
		speed_flag = 1;
	}
}
/* USER CODE END 4 */
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
