MartinavdM/TP_AAA/Core/Inc/main.h

#define USR_BTN_Pin GPIO_PIN_13
#define USR_BTN_GPIO_Port GPIOC
#define USR_BTN_EXTI_IRQn EXTI15_10_IRQn
#define U_VPh_Pin GPIO_PIN_0
#define U_VPh_GPIO_Port GPIOC
#define W_VPh_Pin GPIO_PIN_1
#define W_VPh_GPIO_Port GPIOC
#define Bus_Imes_Pin GPIO_PIN_2
#define Bus_Imes_GPIO_Port GPIOC
#define V_VPh_Pin GPIO_PIN_3
#define V_VPh_GPIO_Port GPIOC
#define Bus_V_Pin GPIO_PIN_0
#define Bus_V_GPIO_Port GPIOA
#define U_Imes_Pin GPIO_PIN_1
#define U_Imes_GPIO_Port GPIOA
#define USR_LED_Pin GPIO_PIN_5
#define USR_LED_GPIO_Port GPIOA
#define W_Imes_ADC1_IN15_Pin GPIO_PIN_0
#define W_Imes_ADC1_IN15_GPIO_Port GPIOB
#define V_Imes_ADC1_IN12_Pin GPIO_PIN_1
#define V_Imes_ADC1_IN12_GPIO_Port GPIOB
#define U_PWM_L_Pin GPIO_PIN_13
#define U_PWM_L_GPIO_Port GPIOB
#define V_PWM_L_Pin GPIO_PIN_14
#define V_PWM_L_GPIO_Port GPIOB
#define W_PWM_L_Pin GPIO_PIN_15
#define W_PWM_L_GPIO_Port GPIOB
#define U_PWM_H_Pin GPIO_PIN_8
#define U_PWM_H_GPIO_Port GPIOA
#define V_PWM_H_Pin GPIO_PIN_9
#define V_PWM_H_GPIO_Port GPIOA
#define W_PWM_H_Pin GPIO_PIN_10
#define W_PWM_H_GPIO_Port GPIOA
#define T_SWDIO_Pin GPIO_PIN_13
#define T_SWDIO_GPIO_Port GPIOA
#define T_SWCLK_Pin GPIO_PIN_14
#define T_SWCLK_GPIO_Port GPIOA
#define NRST_SafetyUC_Pin GPIO_PIN_2
#define NRST_SafetyUC_GPIO_Port GPIOD
#define T_SWO_Pin GPIO_PIN_3
#define T_SWO_GPIO_Port GPIOB
