MartinavdM/TP_AAA/Core/Inc/set_motor_speed.h

/*
 * set_motor_speed.h
 *
 *  Created on: Oct 18, 2023
 *      Author: peret
 */

#ifndef INC_SET_MOTOR_SPEED_H_
#define INC_SET_MOTOR_SPEED_H_

#include "main.h"
#define COUNTER_PERIOD 1023
void set_motor_speed(int);

#endif /* INC_SET_MOTOR_SPEED_H_ */
