MartinavdM/TP_AAA/Core/Inc/compute_current.h

/*
 * compute_current.h
 *
 *  Created on: Oct 18, 2023
 *      Author: peret
 */

#ifndef INC_COMPUTE_CURRENT_H_
#define INC_COMPUTE_CURRENT_H_

#include "main.h"
float compute_current(uint32_t);

#endif /* INC_COMPUTE_CURRENT_H_ */
