MartinavdM/TP_AAA/Core/Inc/current_enslavement.h

/*
 * current_enslavement.h
 *
 *  Created on: Oct 27, 2023
 *      Author: peret
 */

#ifndef INC_CURRENT_ENSLAVEMENT_H_
#define INC_CURRENT_ENSLAVEMENT_H_

void current_enslavement(void);

#endif /* INC_CURRENT_ENSLAVEMENT_H_ */
