MartinavdM/TP_AAA/Core/Inc/compute_speed.h

/*
 * compute_speed.h
 *
 *  Created on: Oct 26, 2023
 *      Author: peret
 */

#ifndef INC_COMPUTE_SPEED_H_
#define INC_COMPUTE_SPEED_H_

float compute_speed(float*);

#endif /* INC_COMPUTE_SPEED_H_ */
