MartinavdM/TP_AAA/Core/Inc/speed_enslavement.h

/*
 * current_enslavement.h
 *
 *  Created on: Oct 26, 2023
 *      Author: peret
 */

#ifndef INC_SPEED_ENSLAVEMENT_H_
#define INC_SPEED_ENSLAVEMENT_H_

void speed_enslavement(void);

#endif /* INC_SPEED_ENSLAVEMENT_H_ */
